crikeyk/XMAS_2026/candy-cane.jpg

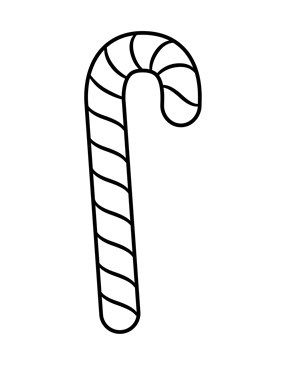
candy-cane.jpg
