crikeyk/XMAS_2026/PCB/XMAS_2026.kicad_pcb

## KiCad design PCB/XMAS_2026.kicad_pcb (2026-11-12)

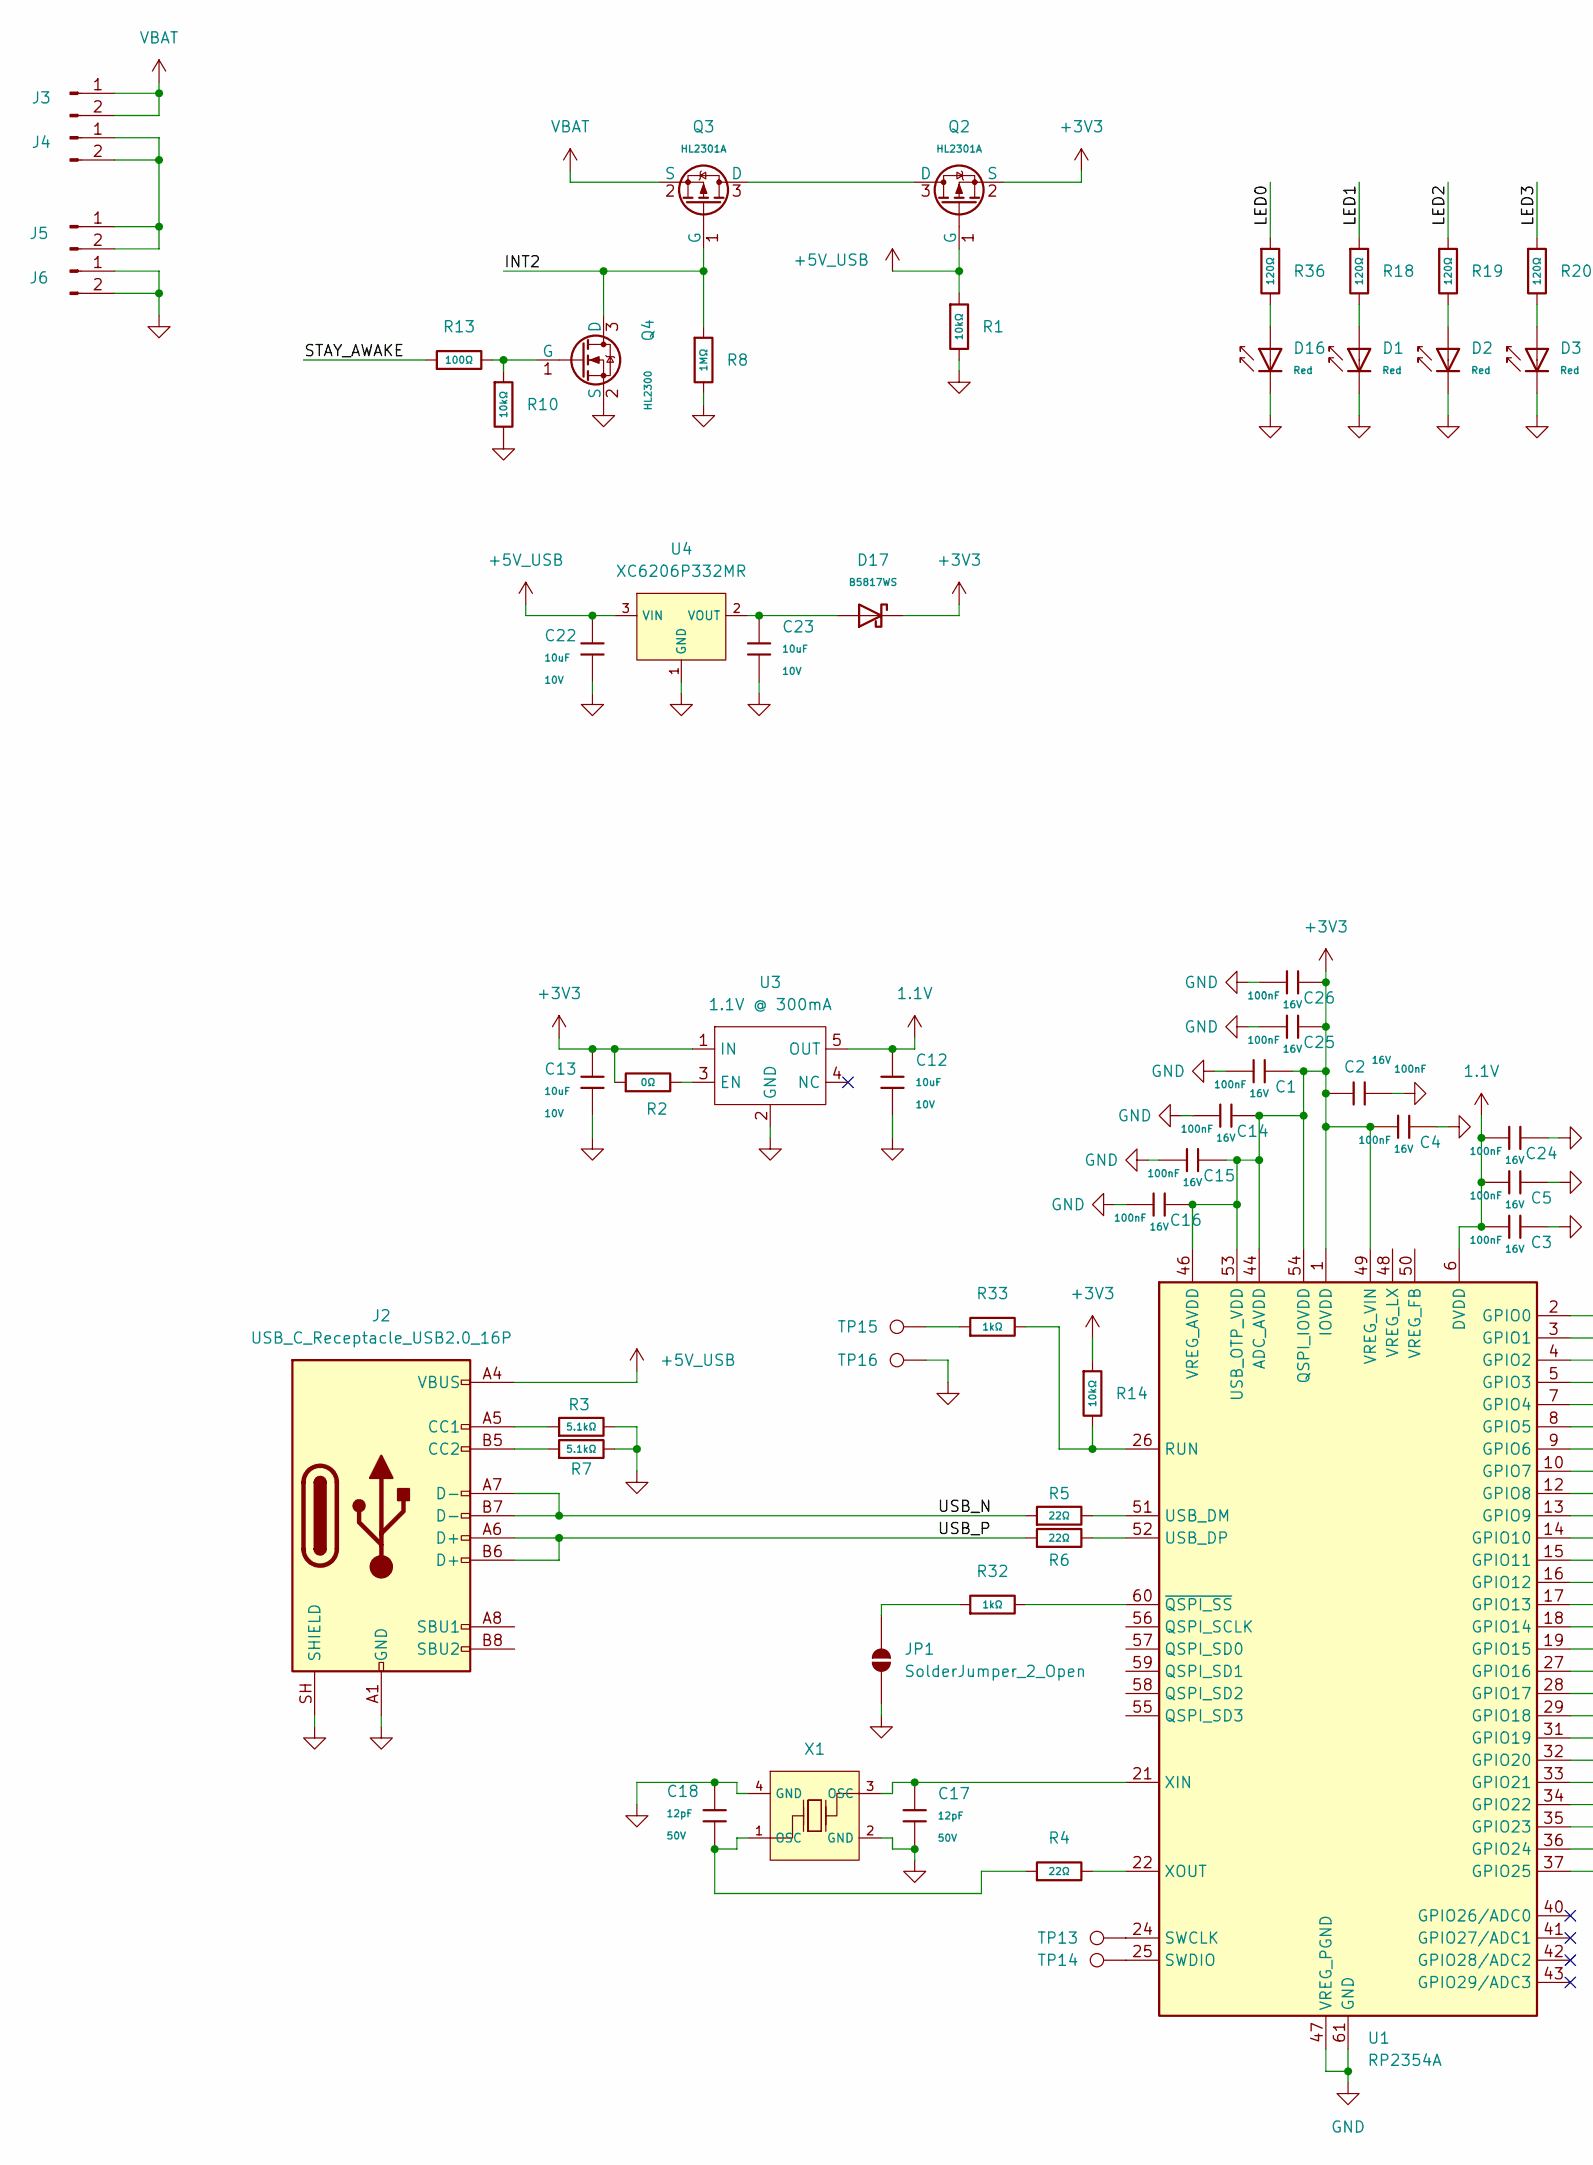
[picture p2: schematic XMAS_2026.kicad_sch, part in row 1, column 1]

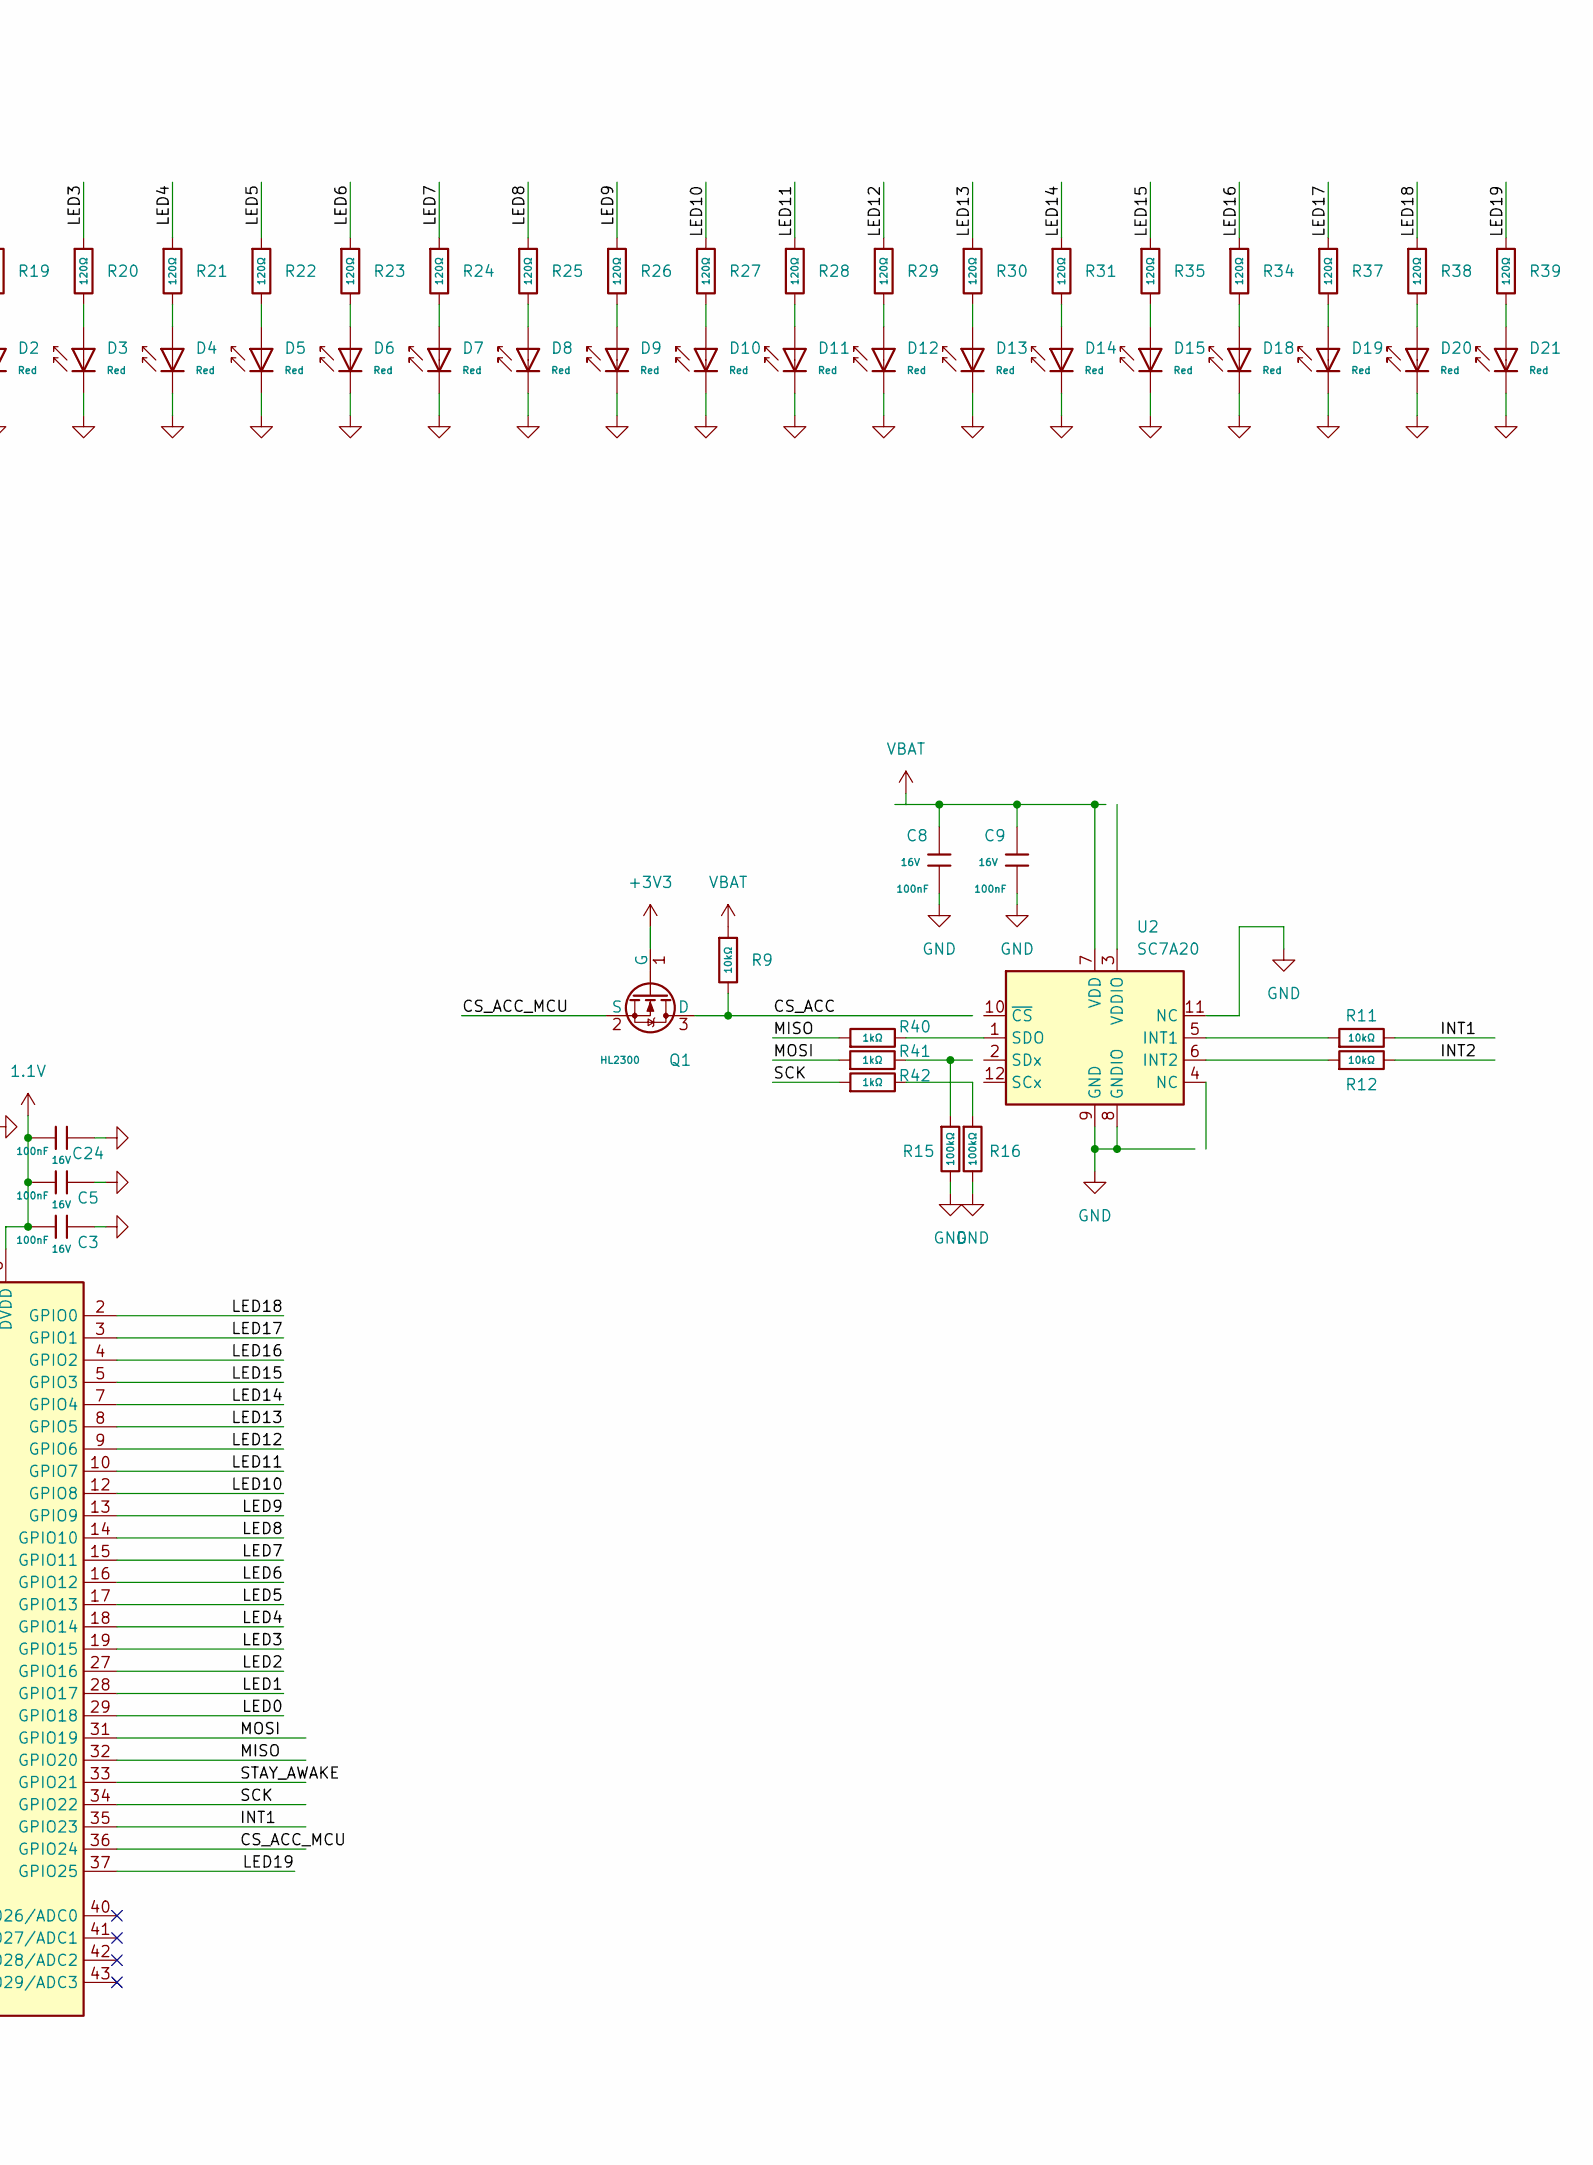
[picture p3: schematic XMAS_2026.kicad_sch, part in row 1, column 2]

Parts:
C1, C2, C3, C4, C5, C8, C9, C14, C15, C16, C24, C25, C26: 100nF; C_0402; Voltage Rated 16V; Tolerance ±10%; Part CL05B104KO5NNNC; LCSC C1525
C12, C13, C22, C23: 10uF; C_0603; Voltage Rated 10V; Tolerance ±10%; Part CL10A106KP8NNNC; LCSC C19702
C17, C18: 12pF; C_0402; Voltage Rated 50V; Tolerance ±5%; Part 0402CG120J500NT; LCSC C1547
D1, D2, D3, D4, D5, D6, D7, D8, D9, D10, D11, D12, D13, D14, D15, D16, D18, D19, D20, D21: Red; D_0603; Part KT-0603R; LCSC C2286
D17: B5817WS; D_SOD-323; Forward Voltage (Vf@If) 450mV@1.0A; Reverse Voltage (Vr) 20V; Part B5817WS; LCSC C7420329
J2: USB_C_Receptacle_USB2.0_16P; USB_C_Receptacle_HRO_TYPE-C-31-M-12; LCSC C165948
J3, J4, J5, J6: Conn_01x02_Pin; BC-8200 AAA Battery clip; LCSC C2979181
JP1: SolderJumper_2_Open; SolderJumper-2_P1.3mm_Open_TrianglePad1.0x1.5mm
Q1, Q4: HL2300; Q_SOT-23; Part HL2300; LCSC C7420343
Q2, Q3: HL2301A; Q_SOT-23; Part HL2301A; LCSC C7420344
R1, R9, R10, R11, R12, R14: 10kΩ; R_0402; Overload Voltage (Max) 50V; Tolerance ±1%; Part 0402WGF1002TCE; LCSC C25744
R2: 0Ω; R_0402; Overload Voltage (Max) 50V; Tolerance ±1%; Part 0402WGF0000TCE; LCSC C17168
R3, R7: 5.1kΩ; R_0402; Overload Voltage (Max) 50V; Tolerance ±1%; Part 0402WGF5101TCE; LCSC C25905
R4, R5, R6: 22Ω; R_0402; Overload Voltage (Max) 50V; Tolerance ±1%; Part 0402WGF220JTCE; LCSC C25092
R8: 1MΩ; R_0402; Overload Voltage (Max) 50V; Tolerance ±1%; Part 0402WGF1004TCE; LCSC C26083
R13: 100Ω; R_0402; Overload Voltage (Max) 50V; Tolerance ±1%; Part 0402WGF1000TCE; LCSC C25076
R15, R16: 100kΩ; R_0402; Overload Voltage (Max) 50V; Tolerance ±1%; Part 0402WGF1003TCE; LCSC C25741
R18, R19, R20, R21, R22, R23, R24, R25, R26, R27, R28, R29, R30, R31, R34, R35, R36, R37, R38, R39: 120Ω; R_0603; Overload Voltage (Max) 75V; Tolerance ±1%; Part 0603WAF1200T5E; LCSC C22787
R32, R33, R40, R41, R42: 1kΩ; R_0402; Overload Voltage (Max) 50V; Tolerance ±1%; Part 0402WGF1001TCE; LCSC C11702
TP13, TP14, TP15, TP16: TestPoint; TestPoint_Pad_D1.0mm
U1: RP2354A; QFN-60-1EP_7x7mm_P0.4mm_EP3.4x3.4mm; LCSC C41378174
U2: SC7A20; LGA-12_2x2mm_P0.5mm; LCSC C19274408
U3: 1.1V @ 300mA; SOT-23-5; LCSC C485147
U4: XC6206P332MR; SOT-23-3_L2.9-W1.6-P1.90-LS2.8-BR; Output Voltage 3.3V; Dropout Voltage 680mV@(100mA); Part XC6206P332MR-G; LCSC C5446
X1: X322512MSB4SI; CRYSTAL-SMD_4P-L3.2-W2.5-BL; Frequency Tolerance ±10ppm; Part X322512MSB4SI; LCSC C9002

Connections:
1.1V: C3.2, C5.2, C12.1, C24.2, U1.6 (DVDD), U1.23 (DVDD), U1.39 (DVDD), U3.5 (OUT)
+3V3: C1.1, C2.1, C4.2, C13.1, C14.1, C15.1, C16.1, C25.1, C26.1, D17.1, Q1.1 (G), Q2.2 (S), R2.1, R14.1, U1.1 (IOVDD), U1.11 (IOVDD), U1.20 (IOVDD), U1.30 (IOVDD), U1.38 (IOVDD), U1.44 (ADC_AVDD), U1.45 (IOVDD), U1.46 (VREG_AVDD), U1.49 (VREG_VIN), U1.53 (USB_OTP_VDD), U1.54 (QSPI_IOVDD), U3.1 (IN)
+5V_USB: C22.1, J2.A4 (VBUS), J2.A9 (VBUS), J2.B4 (VBUS), J2.B9 (VBUS), Q2.1 (G), R1.1, U4.3 (VIN)
/CS_ACC: Q1.3 (D), R9.2
/CS_ACC_MCU: Q1.2 (S), U1.36 (GPIO24)
/INT1: R11.2, U1.35 (GPIO23)
/INT2: Q3.1 (G), Q4.3 (D), R8.1, R12.2
/LED0: R36.1, U1.29 (GPIO18)
/LED1: R18.1, U1.28 (GPIO17)
/LED2: R19.1, U1.27 (GPIO16)
/LED3: R20.1, U1.19 (GPIO15)
/LED4: R21.1, U1.18 (GPIO14)
/LED5: R22.1, U1.17 (GPIO13)
/LED6: R23.1, U1.16 (GPIO12)
/LED7: R24.1, U1.15 (GPIO11)
/LED8: R25.1, U1.14 (GPIO10)
/LED9: R26.1, U1.13 (GPIO9)
/LED10: R27.1, U1.12 (GPIO8)
/LED11: R28.1, U1.10 (GPIO7)
/LED12: R29.1, U1.9 (GPIO6)
/LED13: R30.1, U1.8 (GPIO5)
/LED14: R31.1, U1.7 (GPIO4)
/LED15: R35.1, U1.5 (GPIO3)
/LED16: R34.1, U1.4 (GPIO2)
/LED17: R37.1, U1.3 (GPIO1)
/LED18: R38.1, U1.2 (GPIO0)
/LED19: R39.1, U1.37 (GPIO25)
/MISO: R40.1, U1.32 (GPIO20)
/MOSI: R41.1, U1.31 (GPIO19)
/SCK: R42.1, U1.34 (GPIO22)
/STAY_AWAKE: R13.1, U1.33 (GPIO21)
/USB_N: J2.A7 (D-), J2.B7 (D-), R5.1
/USB_P: J2.A6 (D+), J2.B6 (D+), R6.1
GND: C1.2, C2.2, C3.1, C4.1, C5.1, C8.2, C9.2, C12.2, C13.2, C14.2, C15.2, C16.2, C17.2, C18.2, C22.2, C23.2, C24.1, C25.2, C26.2, D1.1, D2.1, D3.1, D4.1, D5.1, D6.1, D7.1, D8.1, D9.1, D10.1, D11.1, D12.1, D13.1, D14.1, D15.1, D16.1, D18.1, D19.1, D20.1, D21.1, J2.A1 (GND), J2.A12 (GND), J2.B1 (GND), J2.B12 (GND), J2.SH (SHIELD), J6.1, J6.2, JP1.1 (A), Q4.2 (S), R1.2, R3.2, R7.2, R8.2, R10.2, R15.2, R16.2, TP16.1 (1_1), U1.47 (VREG_PGND), U1.61 (GND), U2.8 (GNDIO), U2.9 (GND), U2.11 (NC), U3.2 (GND), U4.1 (GND), X1.2 (GND), X1.4 (GND)
unnamed: C18.1, R4.1, X1.1 (OSC)
unnamed: D1.2, R18.2
unnamed: D2.2, R19.2
unnamed: D3.2, R20.2
unnamed: D4.2, R21.2
unnamed: D5.2, R22.2
unnamed: D6.2, R23.2
unnamed: D7.2, R24.2
unnamed: D8.2, R25.2
unnamed: D9.2, R26.2
unnamed: D10.2, R27.2
unnamed: D11.2, R28.2
unnamed: D12.2, R29.2
unnamed: D13.2, R30.2
unnamed: D14.2, R31.2
unnamed: D15.2, R35.2
unnamed: D16.2, R36.2
unnamed: D18.2, R34.2
unnamed: D19.2, R37.2
unnamed: D20.2, R38.2
unnamed: D21.2, R39.2
unnamed: J2.A5 (CC1), R3.1
unnamed: J2.B5 (CC2), R7.1
unnamed: J4.1, J4.2, J5.1, J5.2
unnamed: JP1.2 (B), R32.1
unnamed: Q2.3 (D), Q3.3 (D)
unnamed: Q4.1 (G), R10.1, R13.2
unnamed: R15.1, R41.2
unnamed: R16.1, R42.2
unnamed: R33.1, TP15.1 (1_1)
unnamed: R14.2, R33.2, U1.26 (RUN)
unnamed: TP13.1 (1_1), U1.24 (SWCLK)
unnamed: TP14.1 (1_1), U1.25 (SWDIO)
unnamed: R5.2, U1.51 (USB_DM)
unnamed: R6.2, U1.52 (USB_DP)
unnamed: C17.1, U1.21 (XIN), X1.3 (OSC)
unnamed: R4.2, U1.22 (XOUT)
unnamed: R32.2, U1.60 (~QSPI_SS)
unnamed: R11.1, U2.5 (INT1)
unnamed: R12.1, U2.6 (INT2)
unnamed: R40.2, U2.1 (SDO)
unnamed: C8.1, C9.1, U2.7 (VDD)
unnamed: R2.2, U3.3 (EN)
unnamed: C23.1, D17.2, U4.2 (VOUT)
VBAT: J3.1, J3.2, Q3.2 (S), R9.1

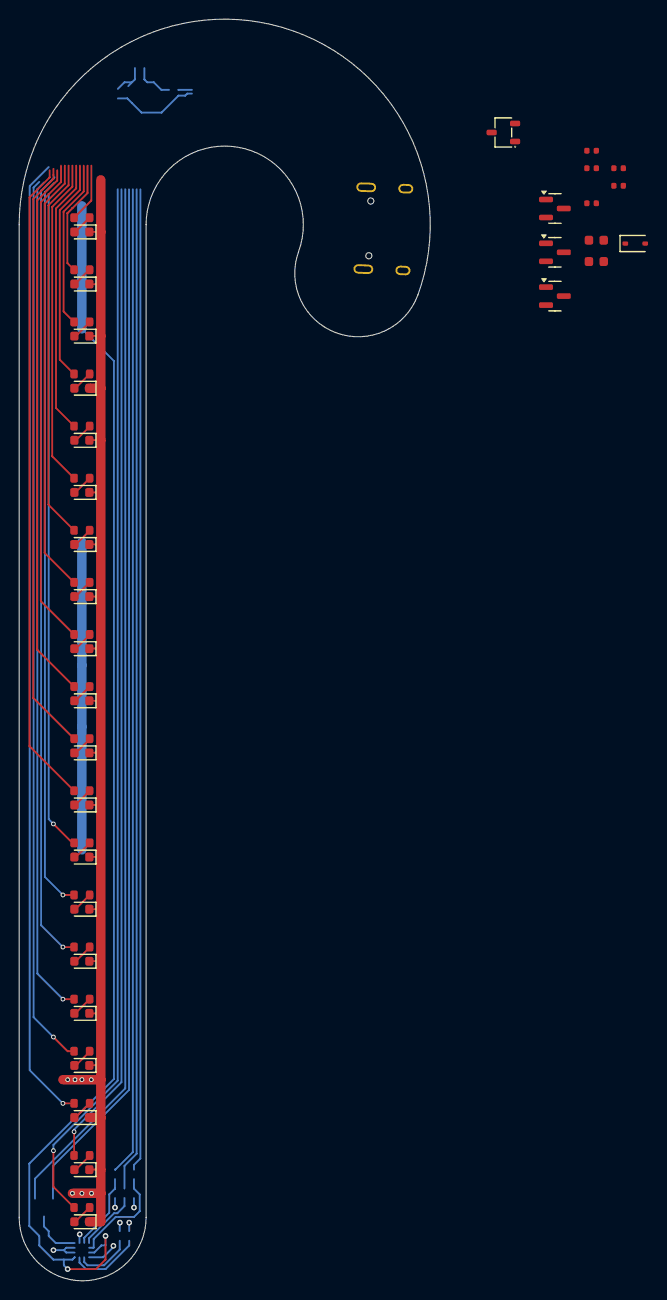
[picture p4: board XMAS_2026.kicad_pcb from above]

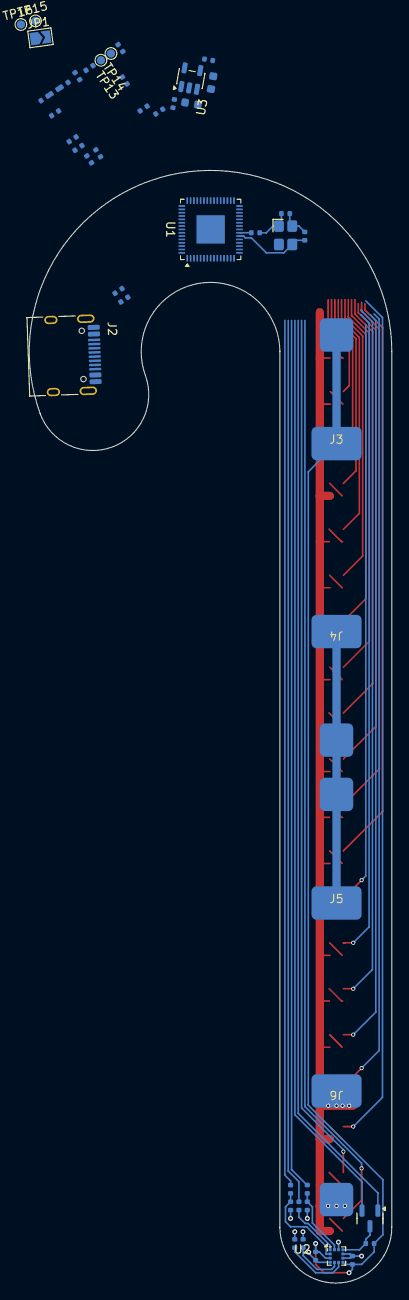
[picture p5: board XMAS_2026.kicad_pcb from below]

Board: 4 copper layers, 43.4 x 133.2 mm, 100 parts (48 on the bottom side), 79 nets.
