crikeyk/XMAS_2026/Firmware/rp2350/tusb_config.h

#ifndef _TUSB_CONFIG_H_
#define _TUSB_CONFIG_H_

#ifdef __cplusplus
extern "C" {
#endif

#ifndef BOARD_TUD_RHPORT
#define BOARD_TUD_RHPORT 0
#endif
#ifndef BOARD_TUD_MAX_SPEED
#define BOARD_TUD_MAX_SPEED OPT_MODE_DEFAULT_SPEED
#endif

#ifndef CFG_TUSB_MCU
#error CFG_TUSB_MCU must be defined
#endif
#ifndef CFG_TUSB_OS
#define CFG_TUSB_OS OPT_OS_PICO
#endif
#ifndef CFG_TUSB_DEBUG
#define CFG_TUSB_DEBUG 0
#endif

#define CFG_TUD_ENABLED 1
#define CFG_TUD_MAX_SPEED BOARD_TUD_MAX_SPEED

#ifndef CFG_TUSB_MEM_SECTION
#define CFG_TUSB_MEM_SECTION
#endif
#ifndef CFG_TUSB_MEM_ALIGN
#define CFG_TUSB_MEM_ALIGN __attribute__((aligned(4)))
#endif

#ifndef CFG_TUD_ENDPOINT0_SIZE
#define CFG_TUD_ENDPOINT0_SIZE 64
#endif

#define CFG_TUD_CDC 1
#define CFG_TUD_MSC 1
#define CFG_TUD_HID 0
#define CFG_TUD_MIDI 0
#define CFG_TUD_VENDOR 0

#define CFG_TUD_CDC_RX_BUFSIZE 128
#define CFG_TUD_CDC_TX_BUFSIZE 512
#define CFG_TUD_CDC_EP_BUFSIZE 64
#define CFG_TUD_MSC_EP_BUFSIZE 512

#ifdef __cplusplus
}
#endif

#endif
