crikeyk/XMAS_2026/(commit log)

2026-11-11 Start XMAS_2026 from the PoV display board and firmware.
    Copied PCB and Firmware from PoV_display_PoC and renamed the KiCad project.
    [XMAS_2026.kicad_pcb, XMAS_2026.kicad_sch, bom.csv, capture.csv, designators.csv, positions.csv]
2026-11-11 Link the private KiCad library into the project.
    PCM_JLCPCB and _MyLib now resolve to the sibling kicad-library repo.
2026-11-11 Link only the handmade KiCad parts from the private library.
    The JLCPCB symbols and footprints come from the CDFER package instead.
2026-11-11 Give the candy cane a normal hook sized for both AAA cells.
    [XMAS_2026.kicad_pcb]
2026-11-11 Open the hook and place the circuit along the cane.
    The USB connector sits at the tip with the RP2354A behind it, power between that and the batteries, and the accelerometer at the far end. The LEDs and their resistors run up the front of the arm.
    [XMAS_2026.kicad_pcb, XMAS_2026.kicad_sch]
2026-11-12 led layout done
    [XMAS_2026.kicad_pcb, XMAS_2026.kicad_sch, bom.csv, designators.csv, positions.csv]
